hgmeyer/SolderingStation/README.md

# TheSolderingStation
Fork of [Matthias'](https://debugginglab.wordpress.com/) and [Albert's](http://e-homelab.flyvotech.com/) DIY Soldering Station, based on a project by [Martin Kumm](http://www.martin-kumm.de).

**Please be aware**: Currently this is work in progress. Hence, any changes in code or hardware are highly experimental! Therefore I do not take any responsibility for damage done to you or your belongings!
