hgmeyer/SolderingStation/eagle/thesolderstation_v0.1.sch

## EAGLE design eagle/thesolderstation_v0.1.sch (2015-12-08)

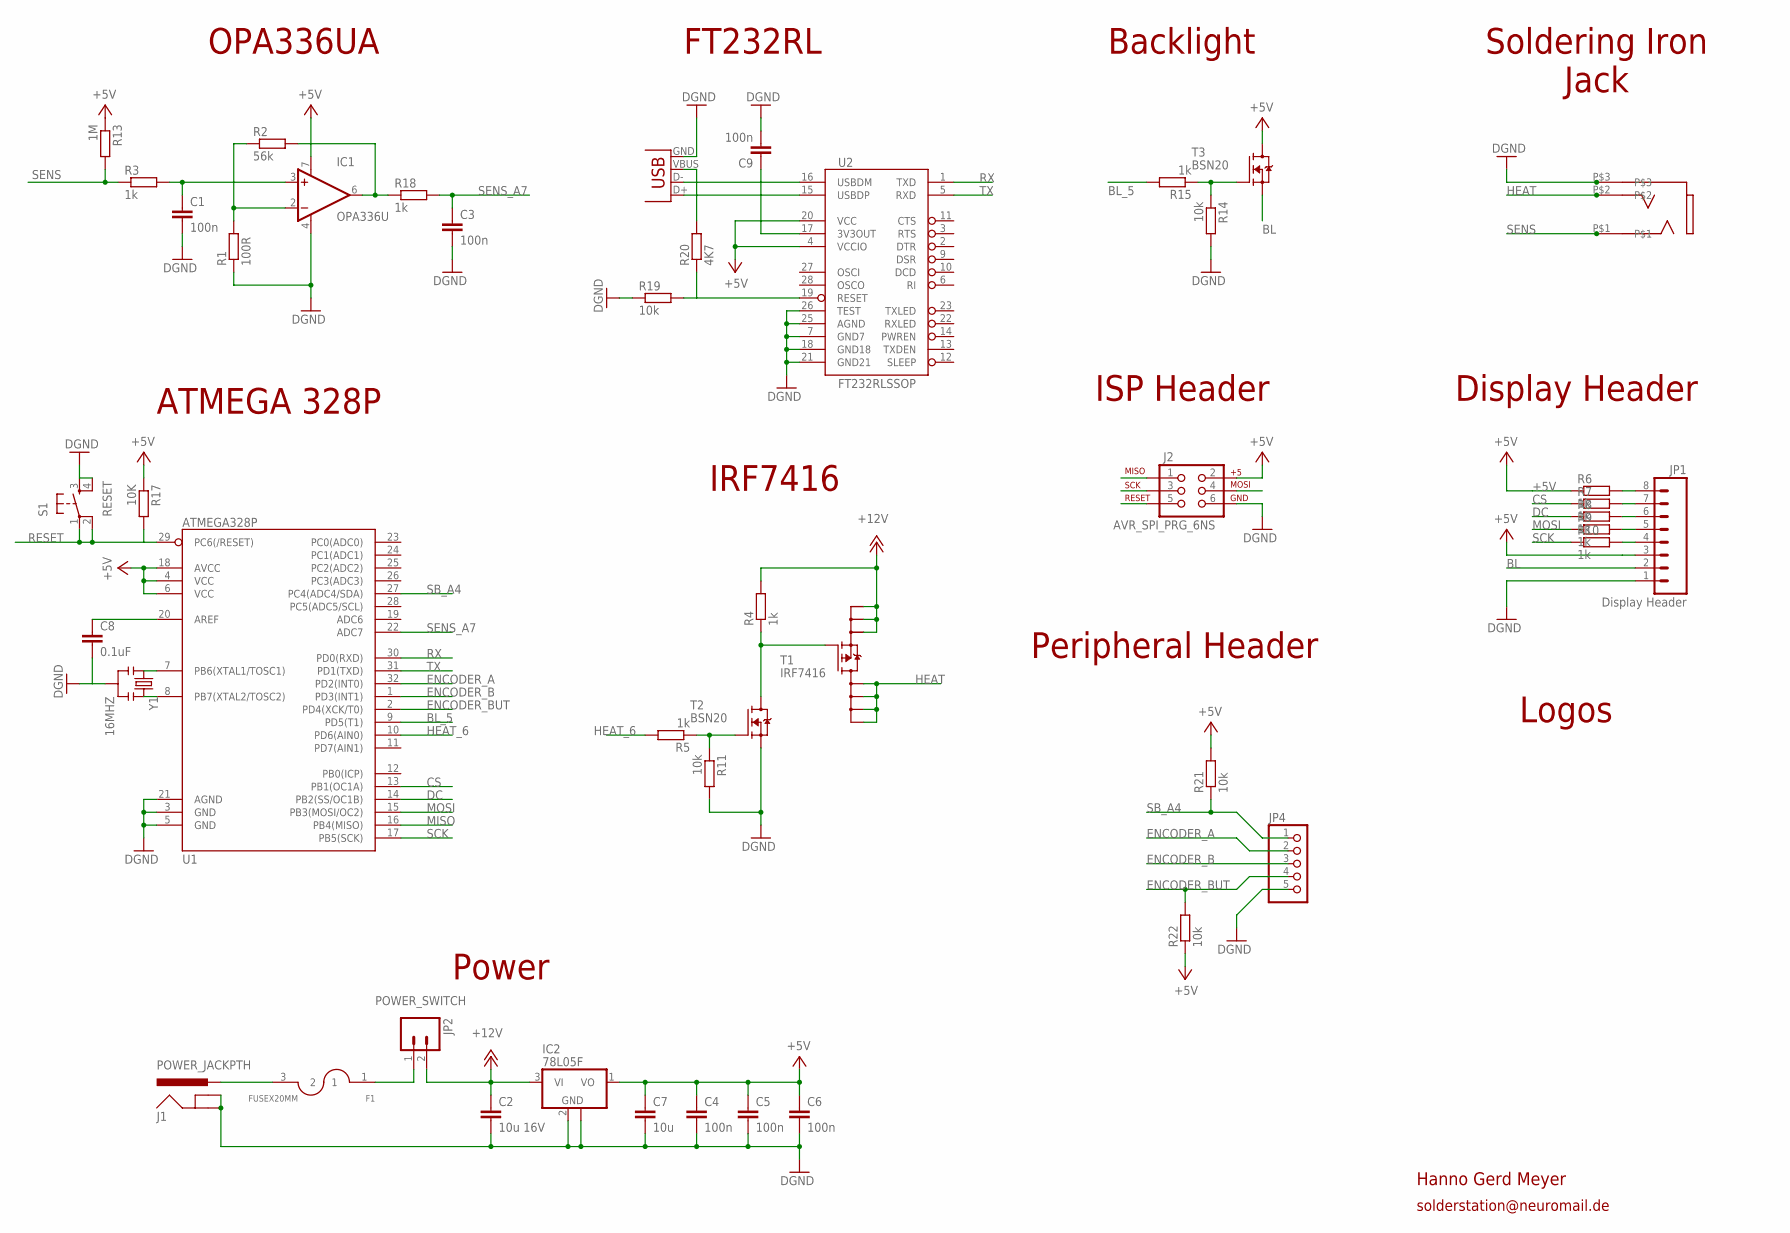
[picture p1: schematic thesolderstation_v0.1.sch]

Parts:
C1, C3, C4, C5, C6, C9: 100n; C0603
C2: 10u 16V; C1206
C7: 10u; C1206
C8: 0.1uF; C0603
F1: FUSEX20MM; FUSE_5MM
IC1: OPA336U; SO08
IC2: 78L05F; SOT89
J1: POWER_JACKPTH; POWER_JACK_PTH
J2: AVR_SPI_PRG_6NS; 2X3-NS
JP1: Display Header; 1X08_LOCK
JP2: POWER_SWITCH; 1X02_LOCK_LONGPADS
JP4: PINHD-1X5; 1X05
JP5: USB-B; USB-B-PTH
R1: 100R; R0603
R2: 56k; R0603
R3, R4, R5, R6, R7, R8, R9, R10, R15, R18: 1k; R0603
R11, R14, R19, R21, R22: 10k; R0603
R13: 1M; R0603
R17: 10K; R0603
R20: 4K7; R0603
S1: RESET; TACTILE-PTH
T1: IRF7416; SO8
T2, T3: BSN20; SOT23
U1: ATMEGA328P; TQFP32-08
U2: FT232RLSSOP; SSOP28DB
U$1: 35RASMT2BHNTRX
Y1: 16MHZ; RESONATOR-SMD

Connections:
+5V: C4.1, C5.1, C6.1, C7.1, IC1.7 (V+), IC2.1 (VO), J2.2, JP1.3, R6.1, R13.1, R17.1, R21.2, R22.1, T3.3 (D), U1.4 (VCC), U1.6 (VCC), U1.18 (AVCC), U2.4 (VCCIO), U2.20 (VCC)
+12V: C2.1, IC2.3 (VI), JP2.2, R4.2, T1.1 (S0), T1.2 (S1), T1.3 (S2)
BL: JP1.2, T3.2 (S)
BL_5: R15.2, U1.9 (PD5(T1))
CS: R7.1, U1.13 (PB1(OC1A))
DC: R8.1, U1.14 (PB2(SS/OC1B))
DGND: C1.2, C2.2, C3.2, C4.2, C5.2, C6.2, C7.2, C8.2, C9.2, IC1.4 (V-), IC2.2 (GND), IC2.2@1 (GND), J1.GND, J1.GNDBREAK, J2.6, JP1.1, JP4.5, JP5.GND, R1.1, R11.2, R14.2, R19.1, S1.3, S1.4, T2.2 (S), U1.3 (GND), U1.5 (GND), U1.21 (AGND), U2.7 (GND7), U2.18 (GND18), U2.21 (GND21), U2.25 (AGND), U2.26 (TEST), U$1.P$3, Y1.2
ENCODER_A: JP4.2, U1.32 (PD2(INT0))
ENCODER_B: JP4.3, U1.1 (PD3(INT1))
ENCODER_BUT: JP4.4, R22.2, U1.2 (PD4(XCK/T0))
HEAT: T1.5 (D0), T1.6 (D1), T1.7 (D2), T1.8 (D3), U$1.P$2
HEAT_6: R5.2, U1.10 (PD6(AIN0))
MISO: J2.1, U1.16 (PB4(MISO))
MOSI: J2.4, R9.1, U1.15 (PB3(MOSI/OC2))
unnamed: IC1.2 (-IN), R1.2, R2.1
unnamed: IC1.6 (OUT), R2.2, R18.1
unnamed: R5.1, R11.1, T2.1 (G)
unnamed: C1.1, IC1.3 (+IN), R3.2
unnamed: R4.1, T1.4 (G), T2.3 (D)
unnamed: JP1.4, R10.2
unnamed: F1.3 (2), J1.PWR
unnamed: JP1.5, R9.2
unnamed: JP1.6, R8.2
unnamed: JP1.7, R7.2
unnamed: JP1.8, R6.2
unnamed: F1.1, JP2.1
unnamed: R14.1, R15.1, T3.1 (G)
unnamed: C8.1, U1.20 (AREF)
unnamed: U1.7 (PB6(XTAL1/TOSC1)), Y1.1
unnamed: U1.8 (PB7(XTAL2/TOSC2)), Y1.3
unnamed: JP5.D-, U2.16 (USBDM)
unnamed: JP5.D+, U2.15 (USBDP)
unnamed: JP5.VBUS, R20.2
unnamed: R19.2, R20.1, U2.19 (RESET)
unnamed: C9.1, U2.17 (3V3OUT)
RESET: J2.5, R17.2, S1.1, S1.2, U1.29 (PC6(/RESET))
RX: U1.30 (PD0(RXD)), U2.1 (TXD)
SB_A4: JP4.1, R21.1, U1.27 (PC4(ADC4/SDA))
SCK: J2.3, R10.1, U1.17 (PB5(SCK))
SENS: R3.1, R13.2, U$1.P$1
SENS_A7: C3.1, R18.2, U1.22 (ADC7)
TX: U1.31 (PD1(TXD)), U2.5 (RXD)

Notes on the sheet:
OPA336UA
ISP Header
IRF7416
Backlight
Soldering Iron Jack
ATMEGA 328P
Display Header
Power
FT232RL
Peripheral Header
Logos
Hanno Gerd Meyer
solderstation@neuromail.de
