hgmeyer/SolderingStation/(commit log)

2015-12-04 Changed PWM pin for heating to account for new board design (3->6)
2015-12-06 Redesigned and cleaned up schematics.
    * Now using an ATMEGA 328p and an FT232RL instead of an Arduino Pro Mini.
    * Replaced potentiometer with rotary encoder
    * Fixed bug in backlight connection
    [thesolderstation_v0.1.sch]
2015-12-07 Switched display's DC and CS pins for better routing
    [thesolderstation_v0.1.sch]
2015-12-08 Switched to a different 3.5mm soldering iron jack as current rating was too low (0.5A).
    [thesolderstation_v0.1.sch]
